peterweissig/eagle_dmx_driver/README.md

# eagle_dmx_driver
Simple galvanic decoupled dmx-driver
