peterweissig/eagle_dmx_driver/export/images/tht/circuit.png

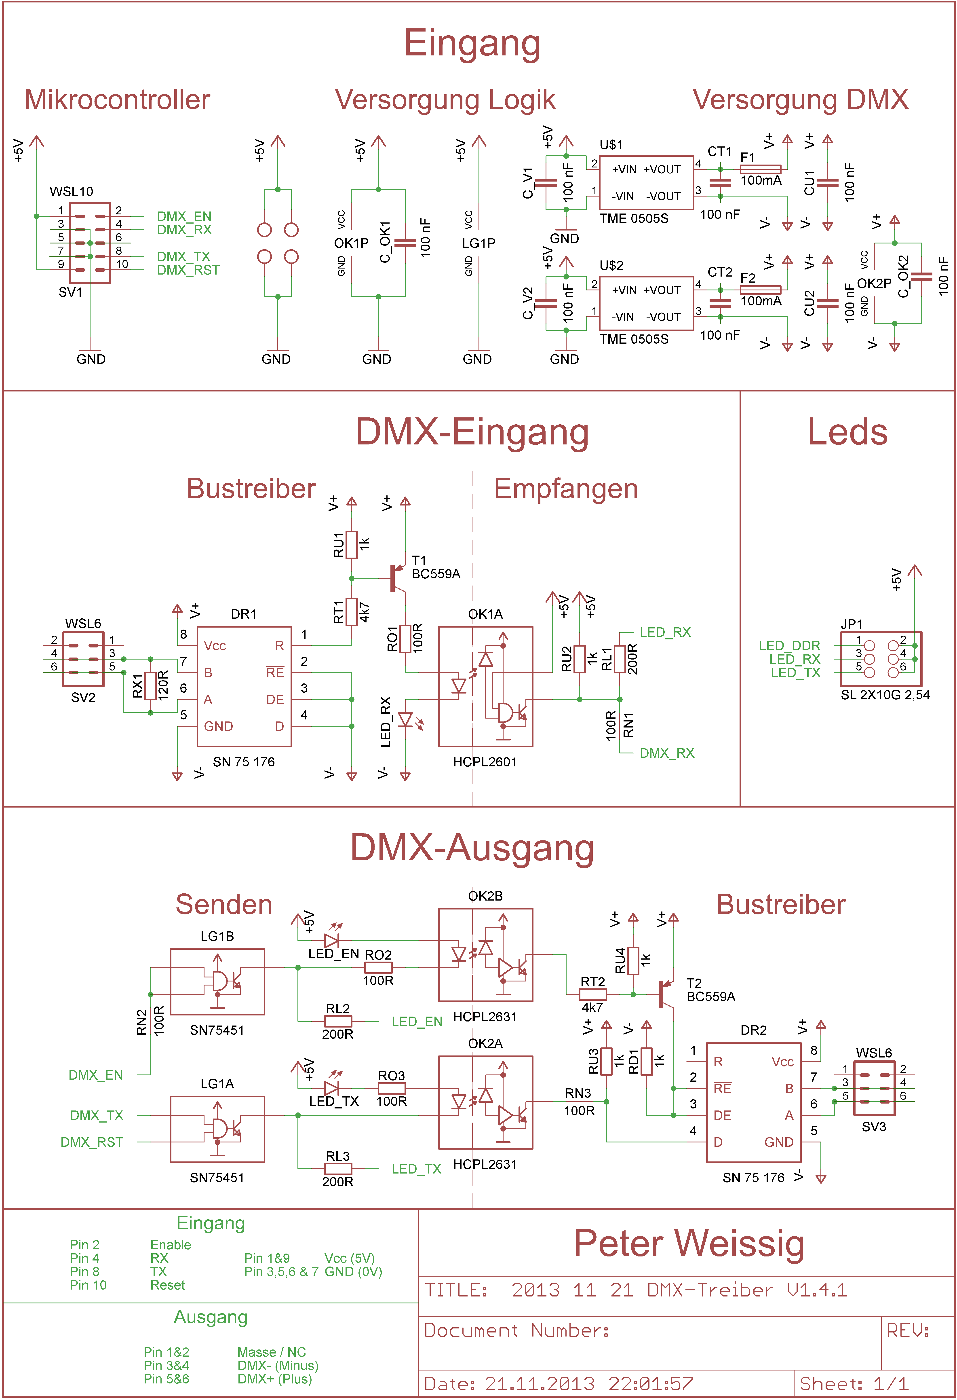
export/images/tht/circuit.png
