peterweissig/eagle_dmx_driver/export/images/tht/layout.png

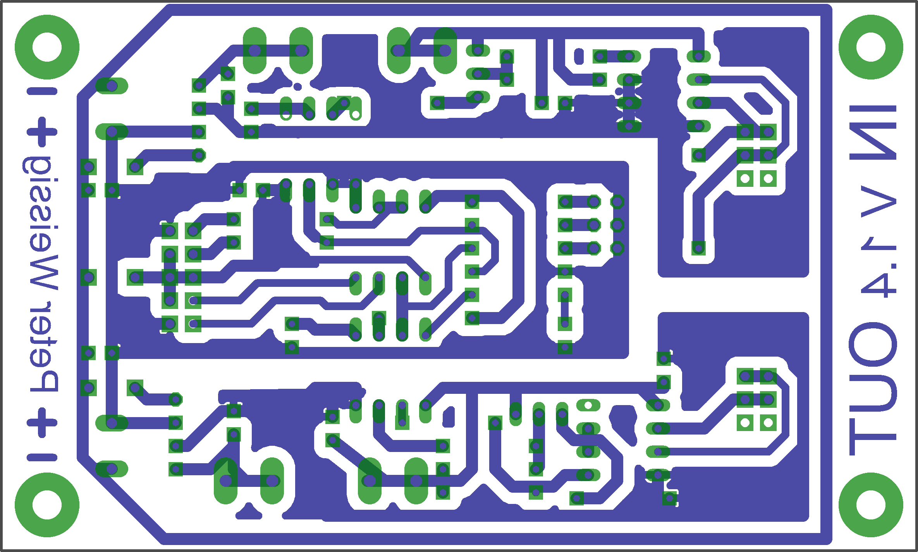
export/images/tht/layout.png
