peterweissig/eagle_dmx_driver/parts/tht/parts.pdf

## Bauteile DMX-Treiber

~ V 1.4.1 ~

19.01.2014

Gruppe | Beschreibung | Bauteile | Anzahl | Händler | BestellNr. | Preis | Summe
Spg-Reg. | SIL4; 5V auf 5V; 1W; Galv. Getrennt | U$x (2x) | 2 | Reichelt | SIM1-0505 SIL4 (http://www.reichelt.de/Wandler-Module-DC-DC/SIM1-0505-SIL4/3/index.html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) | 3,25 € | 6,50 €
ICs | RS485-Treiber; Siehe IC-Sockel | DRx (2x) | 2 | Reichelt | SN 75176BP (http://www.reichelt.de/SN-75176BP/3/index.html?ACTION=3&LA=446&ARTICLE=19202&artnr=SN+75176BP&SEARCH=75176) | 0,26 € | 0,52 €
| Logik; Und-Gatter; Open-Kollektor; Siehe IC-Sockel | LG1 | 1 | Reichelt | SN 75451 (http://www.reichelt.de/ICs-74F-74ALS-SN75-/SN-75451/3/index.html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) | 0,32 € | 0,32 €
| Optokoppler; 1x; Siehe IC-Sockel | OK1 | 1 | Reichelt | HCPL 2601 (http://www.reichelt.de/Optokoppler/HCPL-2601/3/index.html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) | 1,10 € | 1,10 €
| Optokoppler; 2x; Siehe IC-Sockel | OK2 | 1 | Reichelt | HCPL 2631 (http://www.reichelt.de/Optokoppler/HCPL-2631/3/index.html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) | 1,85 € | 1,85 €
Transistoren | Kleinleistungstransistor; PNP; 30V; 100mA; TO92 | Tx (2x) | 2 | Reichelt | BC 559A (http://www.reichelt.de/IC-Sockel/GS-8/3/index.html?ACTION=3;ARTICLE=5023;SEARCH=BC%20559A) | 0,04 € | 0,08 €
Dioden | Led; 3mm; Gelb | LED_EN | 1 | Reichelt | LED 3MM GE (http://www.reichelt.de/LED-3MM-GE/3/index.html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) | 0,07 € | 0,07 €
| Led; 3mm; Grün | LED_RX | 1 | Reichelt | LED 3MM GN (http://www.reichelt.de/LED-3MM-GN/3/index.html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) | 0,06 € | 0,06 €
| Led; 3mm; Rot | LED_TX | 1 | Reichelt | LED 3MM RT (http://www.reichelt.de/IC-Sockel/GS-8/3/index.html?ACTION=3;ARTICLE=10228;SEARCH=LED%203MM%20RT) | 0,06 € | 0,06 €
Kondens. | Kerko; 100nF; 2,5mm | Cxxx (8x) | 8 | Reichelt | X7R-2,5 100N (http://www.reichelt.de/LED-3MM-GE/3/index.html?ACTION=3;ARTICLE=22853;SEARCH=X7R-2,5%20100N) | 0,05 € | 0,40 €
Sicherung | Sicherung; Flink; 0,1A; 250V | Fx (2x) | 2 | Reichelt | FLINK 0,1A (http://www.reichelt.de/LED-3MM-GE/3/index.html?ACTION=3;ARTICLE=7819;SEARCH=FLINK%200,1A) | 0,53 € | 1,06 €
Anschlüße | Schraubanschluss | Xx (2x) | 2 | Reichelt | AKL 101-02 (http://www.reichelt.de/LED-3MM-GE/3/index.html?ACTION=3;ARTICLE=36605;SEARCH=AKL%20101-02) | 0,31 € | 0,62 €
| 2x10 (2x3); 2,54mm; gerade; siehe Buchsenleiste | JP1 | 0,5 | Reichelt | SL 2X10G 2,54 (http://www.reichelt.de/LED-3MM-GE/3/index.html?ACTION=3;ARTICLE=19488;SEARCH=SL%202X10G%202,54) | 0,09 € | 0,05 €
| 2x5; 2,54mm; gerade; Wannenstecker; siehe Pfostenbuchse SV1 | | 1 | Reichelt | WSL 10G (http://www.reichelt.de/Stiftleisten/2/index.html?ACTION=3;ARTICLE=22816;SEARCH=WSL%2010G) | 0,08 € | 0,08 €
| 2x5; 2,54mm; gerade; Wannenstecker; siehe Pfostenbuchse SV2, | SV3 | 2 | Reichelt | WSL 6G (http://www.reichelt.de/Stiftleisten/2/index.html?ACTION=3;ARTICLE=85732;SEARCH=WSL%206G) | 0,17 € | 0,34 €
Widerstände | 4,7k; THT; 0,25W | RTx (2x) | 2 | Reichelt | METALL 4,70K (http://www.reichelt.de/index.html?ACTION=3;ARTICLE=11784;SEARCH=METALL%204,70K) | 0,08 € | 0,16 €
| 1,0k; THT; 0,25W | RD1, RUx (4x) | 5 | Reichelt | METALL 1,00K (http://www.reichelt.de/index.html?ACTION=3;ARTICLE=11403;SEARCH=METALL%201,00K) | 0,08 € | 0,41 €
| 200 R; THT; 0,25W | RLx (3x) | 3 | Reichelt | METALL 200 (http://www.reichelt.de/index.html?ACTION=3;ARTICLE=11609;SEARCH=METALL%20200) | 0,08 € | 0,25 €
| 120 R; THT; 0,25W | RX1 | 1 | Reichelt | METALL 120 (http://www.reichelt.de/METALL-120/3/index.html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) | 0,08 € | 0,08 €
| 100 R; THT; 0,25W | RNx (3x), ROx (3x) | 6 | Reichelt | METALL 100 (http://www.reichelt.de/METALL-120/3/index.html?ACTION=3;ARTICLE=11457;SEARCH=METALL%20100) | 0,08 € | 0,49 €
Zusatz | 5x20mm; Halterungen für Sicherungen | Fx (2x) | 4 | Reichelt | PL 120000 (http://www.reichelt.de/Sicherungshalter/PL-120000/3/index.html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) | 0,07 € | 0,28 €
| 2x13; 2,54mm; gerade; Buchsenleiste | JP1 | 0,3 | Reichelt | BL 2X13G8 2,54 (http://www.reichelt.de/Buchsenleisten/BL-2X13G8-2-54/3/index.html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) | 0,29 € | 0,09 €
| 2x5; 2,54mm; gerade; Pfostenbuchse | SV1 | 1 | Reichelt | PFL 10 (http://www.reichelt.de/Pfosten-Wannenstecker/PFL-10/3/index.html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) | 0,08 € | 0,08 €
| 2x3; 2,54mm; gerade; Pfostenbuchse | SV2 SV3 | 2 | Reichelt | PFL 6 (http://www.reichelt.de/Pfosten-Wannenstecker/2/index.html?ACTION=3;ARTICLE=53153;SEARCH=PFL%206) | 0,24 € | 0,48 €
| DIP8; IC-Sockel | Je IC | 5 | Reichelt | GS 8 (http://www.reichelt.de/IC-Sockel/GS-8/3/index.html?ACTION=3&LA=2&ARTICLE=8230&GROUPID=3215&artnr=GS+8) | 0,04 € | 0,20 €
Summe | 15,63 €
Peter Weissig | V 1.0.0 | Seite 1 von 1
