peterweissig/eagle_dmx_driver/export/images/tht/circuit.pdf

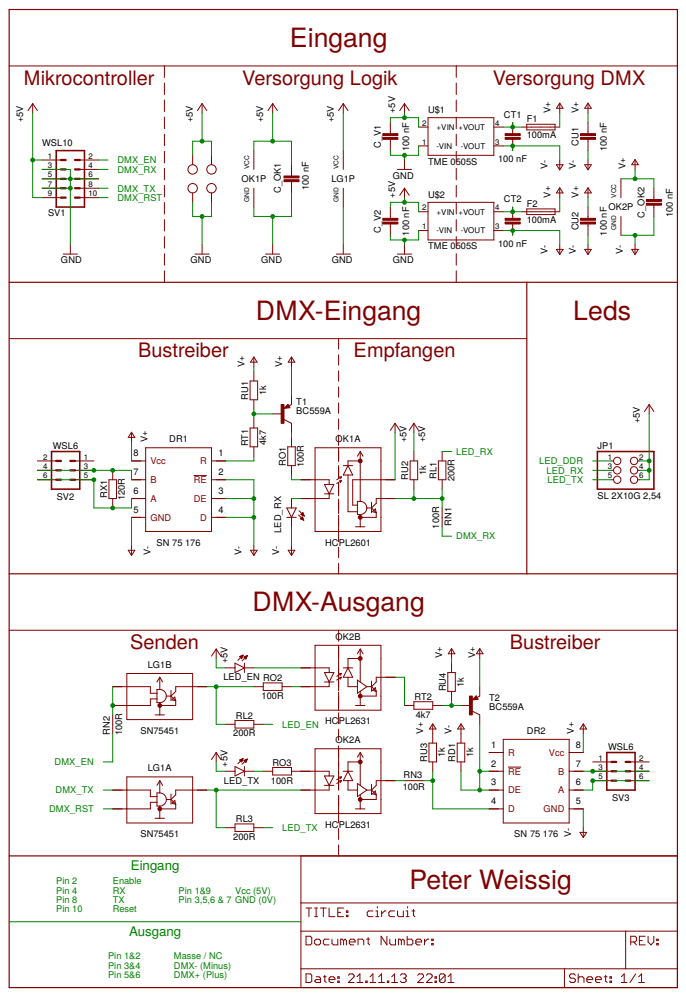
[picture p4: page 1]
