peterweissig/eagle_dmx_driver/circuit/tht/circuit.brd

## EAGLE design circuit/tht/circuit.brd (2018-02-25)

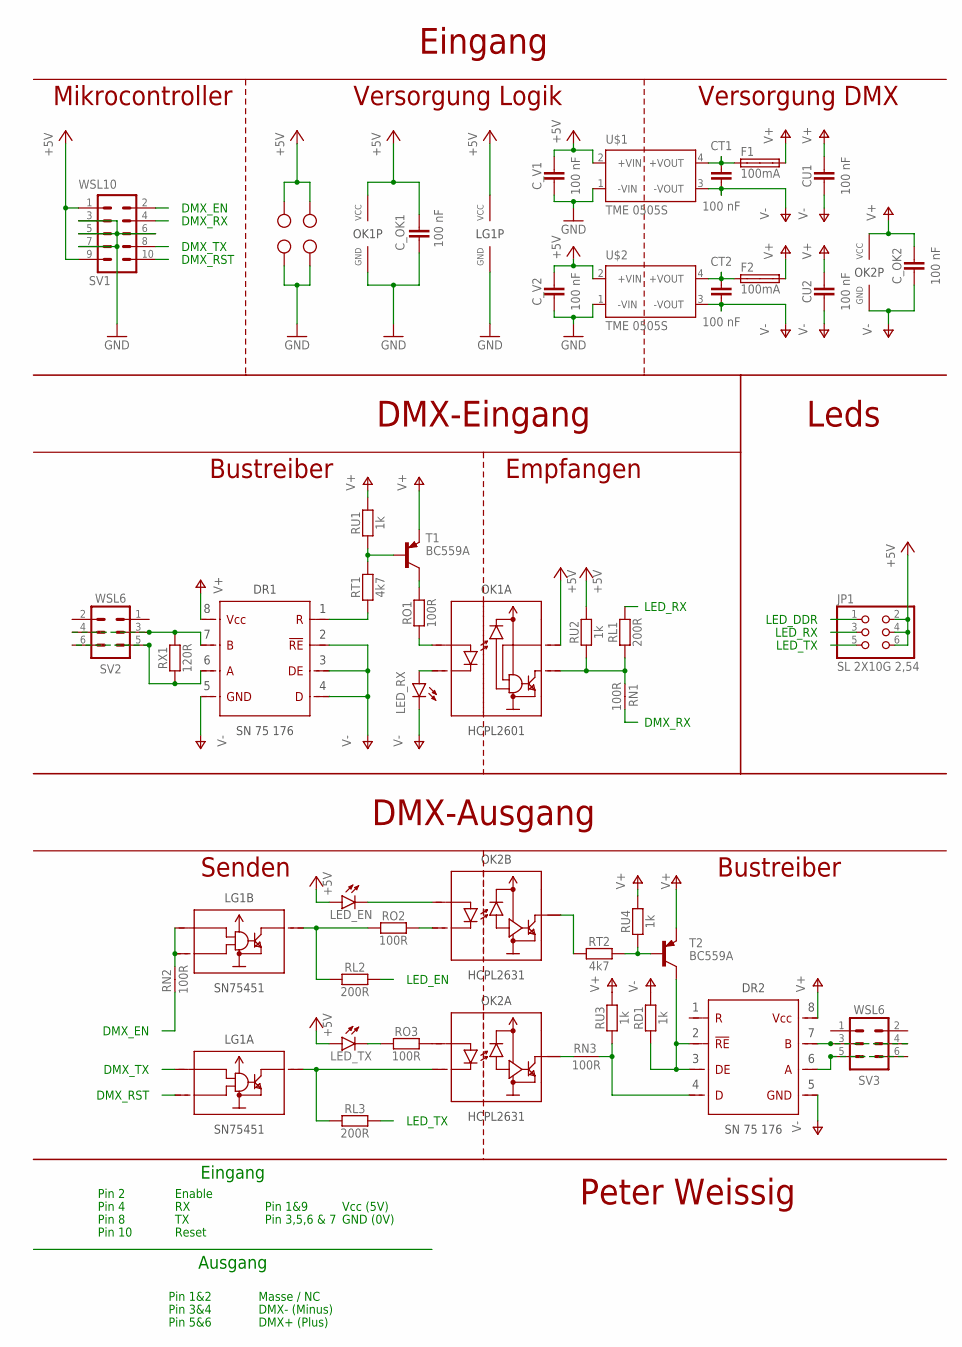
[picture p5: schematic circuit.sch]

Parts:
CT1, CT2: 100 nF; C_THT_2
CU1, CU2: 100 nF; C_THT_2
C_OK1, C_OK2: 100 nF; C_THT_2
C_V1, C_V2: 100 nF; C_THT_2
DR1, DR2: SN75 176; IC_DIL08
F1, F2: 100mA; SHK20L
JP1: SL 2X10G 2,54; 2X03
LED_EN: LED-3MM; LED_3MM
LED_RX: LED-3MM; LED_3MM
LED_TX: LED-3MM; LED_3MM
LG1: SN75451; IC_DIL08_OUT
OK1: HCPL2601; IC_DIL08_OUT
OK2: HCPL2631; IC_DIL08_OUT
RD1: 1k; R_THT_4
RL1, RL2, RL3: 200R; R_THT_4
RN1, RN2, RN3: 100R; R_THT_4
RO1, RO2, RO3: 100R; R_THT_4
RT1, RT2: 4k7; R_THT_4
RU1, RU2, RU3, RU4: 1k; R_THT_4
RX1: 120R; R_THT_4
SV1: WSL10; STECKER_WANNE_10
SV2, SV3: WSL6; STECKER_WANNE_6
T1, T2: BC559A; TO92-EBC
U$1, U$2: TME 0505S; TRACO_TME_1
X1, X2: AKL101-2; W237-102

Connections:
+5V: C_OK1.1, C_V1.1, C_V2.1, JP1.2, JP1.4, JP1.6, LED_EN.A, LED_TX.A, LG1.8 (VCC), OK1.7 (I_EN), OK1.8 (VCC), RU2.2, SV1.1, SV1.9, U$1.2 (+VIN), U$2.2 (+VIN), X1.1, X2.2
DMX_DDR_1_O1: DR2.2, DR2.3, RD1.2, T2.C
DMX_EN: RN2.2, SV1.2
DMX_N_1: DR1.7, RX1.1, SV2.3, SV2.4
DMX_N_2: DR2.7, SV3.3, SV3.4
DMX_P_1: DR1.6, RX1.2, SV2.5, SV2.6
DMX_P_2: DR2.6, SV3.5, SV3.6
DMX_READ_1_O: DR1.1, RT1.2
DMX_RST: LG1.2 (I_2), SV1.10
DMX_RX: RN1.1, SV1.4
DMX_TX: LG1.1 (I_1), SV1.8
GND: C_OK1.2, C_V1.2, C_V2.2, LG1.4 (GND), OK1.5 (GND), SV1.3, SV1.5, SV1.6, SV1.7, U$1.1 (-VIN), U$2.1 (-VIN), X1.2, X2.1
GND_RX: CT1.2, CU1.2, DR1.2, DR1.3, DR1.4, DR1.5, LED_RX.K (C), U$1.3 (-VOUT)
GND_TX: CT2.2, CU2.2, C_OK2.1, DR2.5, OK2.5 (GND), RD1.1, U$2.3 (-VOUT)
LED_EN: JP1.1, RL2.2
LED_RX: JP1.3, RL1.1
LED_TX: JP1.5, RL3.2
unnamed: OK1.6 (O), RL1.2, RN1.2, RU2.1
unnamed: OK2.6 (O), RT2.2
unnamed: OK2.7 (O), RN3.2
unnamed: DR2.4, RN3.1, RU3.2
unnamed: RT1.1, RU1.2, T1.B
unnamed: RT2.1, RU4.2, T2.B
unnamed: LG1.3 (O), OK2.2 (I_K), RL3.1
unnamed: OK2.1 (I_A), RO3.2
unnamed: OK2.3 (I_K), RO2.2
unnamed: LED_TX.K (C), RO3.1
unnamed: CT1.1, F1.1A, U$1.4 (+VOUT)
unnamed: LG1.5 (O), RL2.1, RO2.1
unnamed: LED_EN.K (C), OK2.4 (I_A)
unnamed: LED_RX.A, OK1.3 (I_K)
unnamed: OK1.2 (I_A), RO1.1
unnamed: RO1.2, T1.C
unnamed: CT2.1, F2.1A, U$2.4 (+VOUT)
N$_14: LG1.6 (I_1), LG1.7 (I_2), RN2.1
VCC_RX: CU1.1, DR1.8, F1.2A, RU1.1, T1.E
VCC_TX: CU2.1, C_OK2.2, DR2.8, F2.2A, OK2.8 (VCC), RU3.1, RU4.1, T2.E

Notes on the sheet:
DMX-Eingang
DMX_RX
Eingang
DMX_TX
DMX_EN
Peter Weissig
Empfangen
Bustreiber
LED_RX
DMX-Ausgang
Mikrocontroller
Versorgung DMX
LED_TX
LED_DDR
Senden
LED_EN
Ausgang
Pin 1&2
Pin 3&4
Pin 5&6
Masse / NC
DMX- (Minus)
DMX+ (Plus)
Pin 1&9
Pin 3,5,6 & 7
Vcc (5V)
GND (0V)
Pin 4
Pin 8
Pin 10
Reset
DMX_RST
Versorgung Logik
Leds
Pin 2
Enable

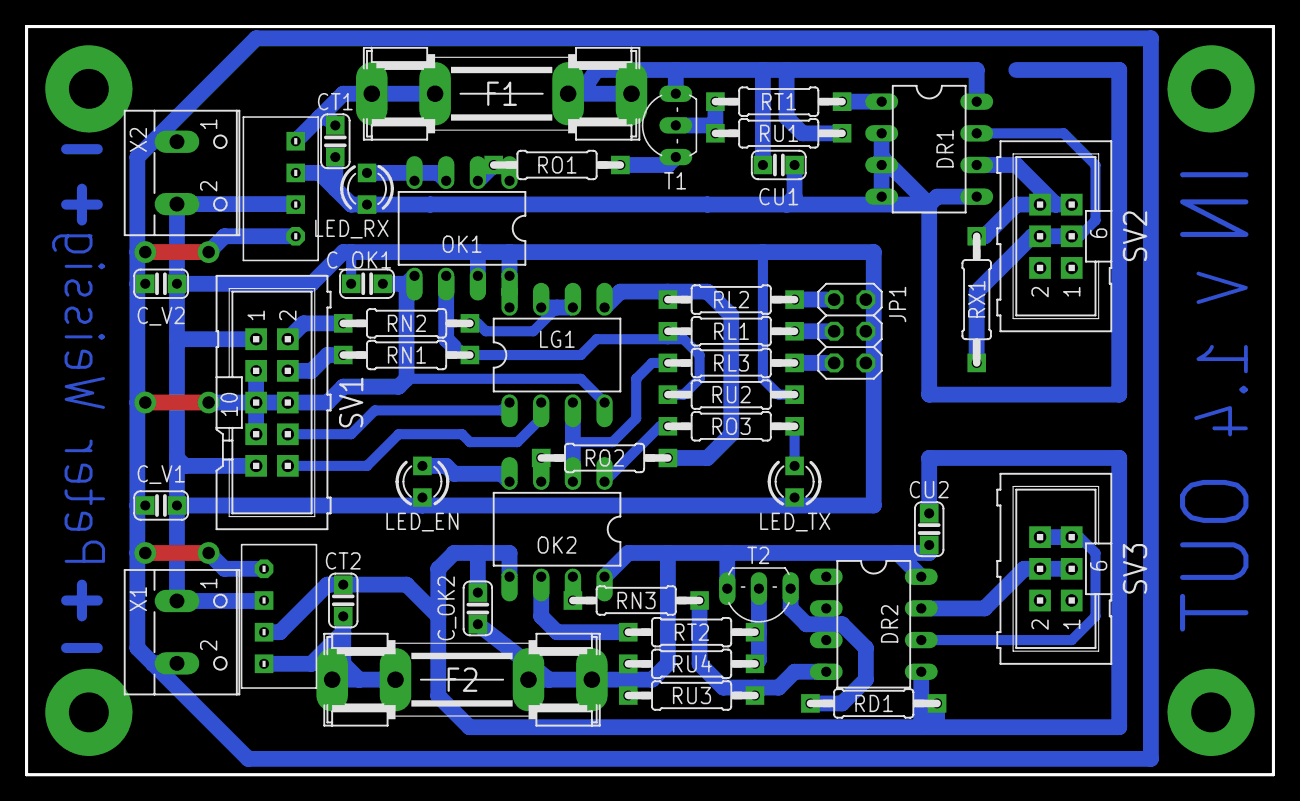
[picture p6: board circuit.brd from above]

Board: 2 copper layers, 100.0 x 60.0 mm, 45 parts (0 on the bottom side), 37 nets.
